Virtex6/Audio3.5Umschalter/8zu1AudioUmschalter.kicad_pcb

## KiCad design 8zu1AudioUmschalter.kicad_pcb (2015-04-05)

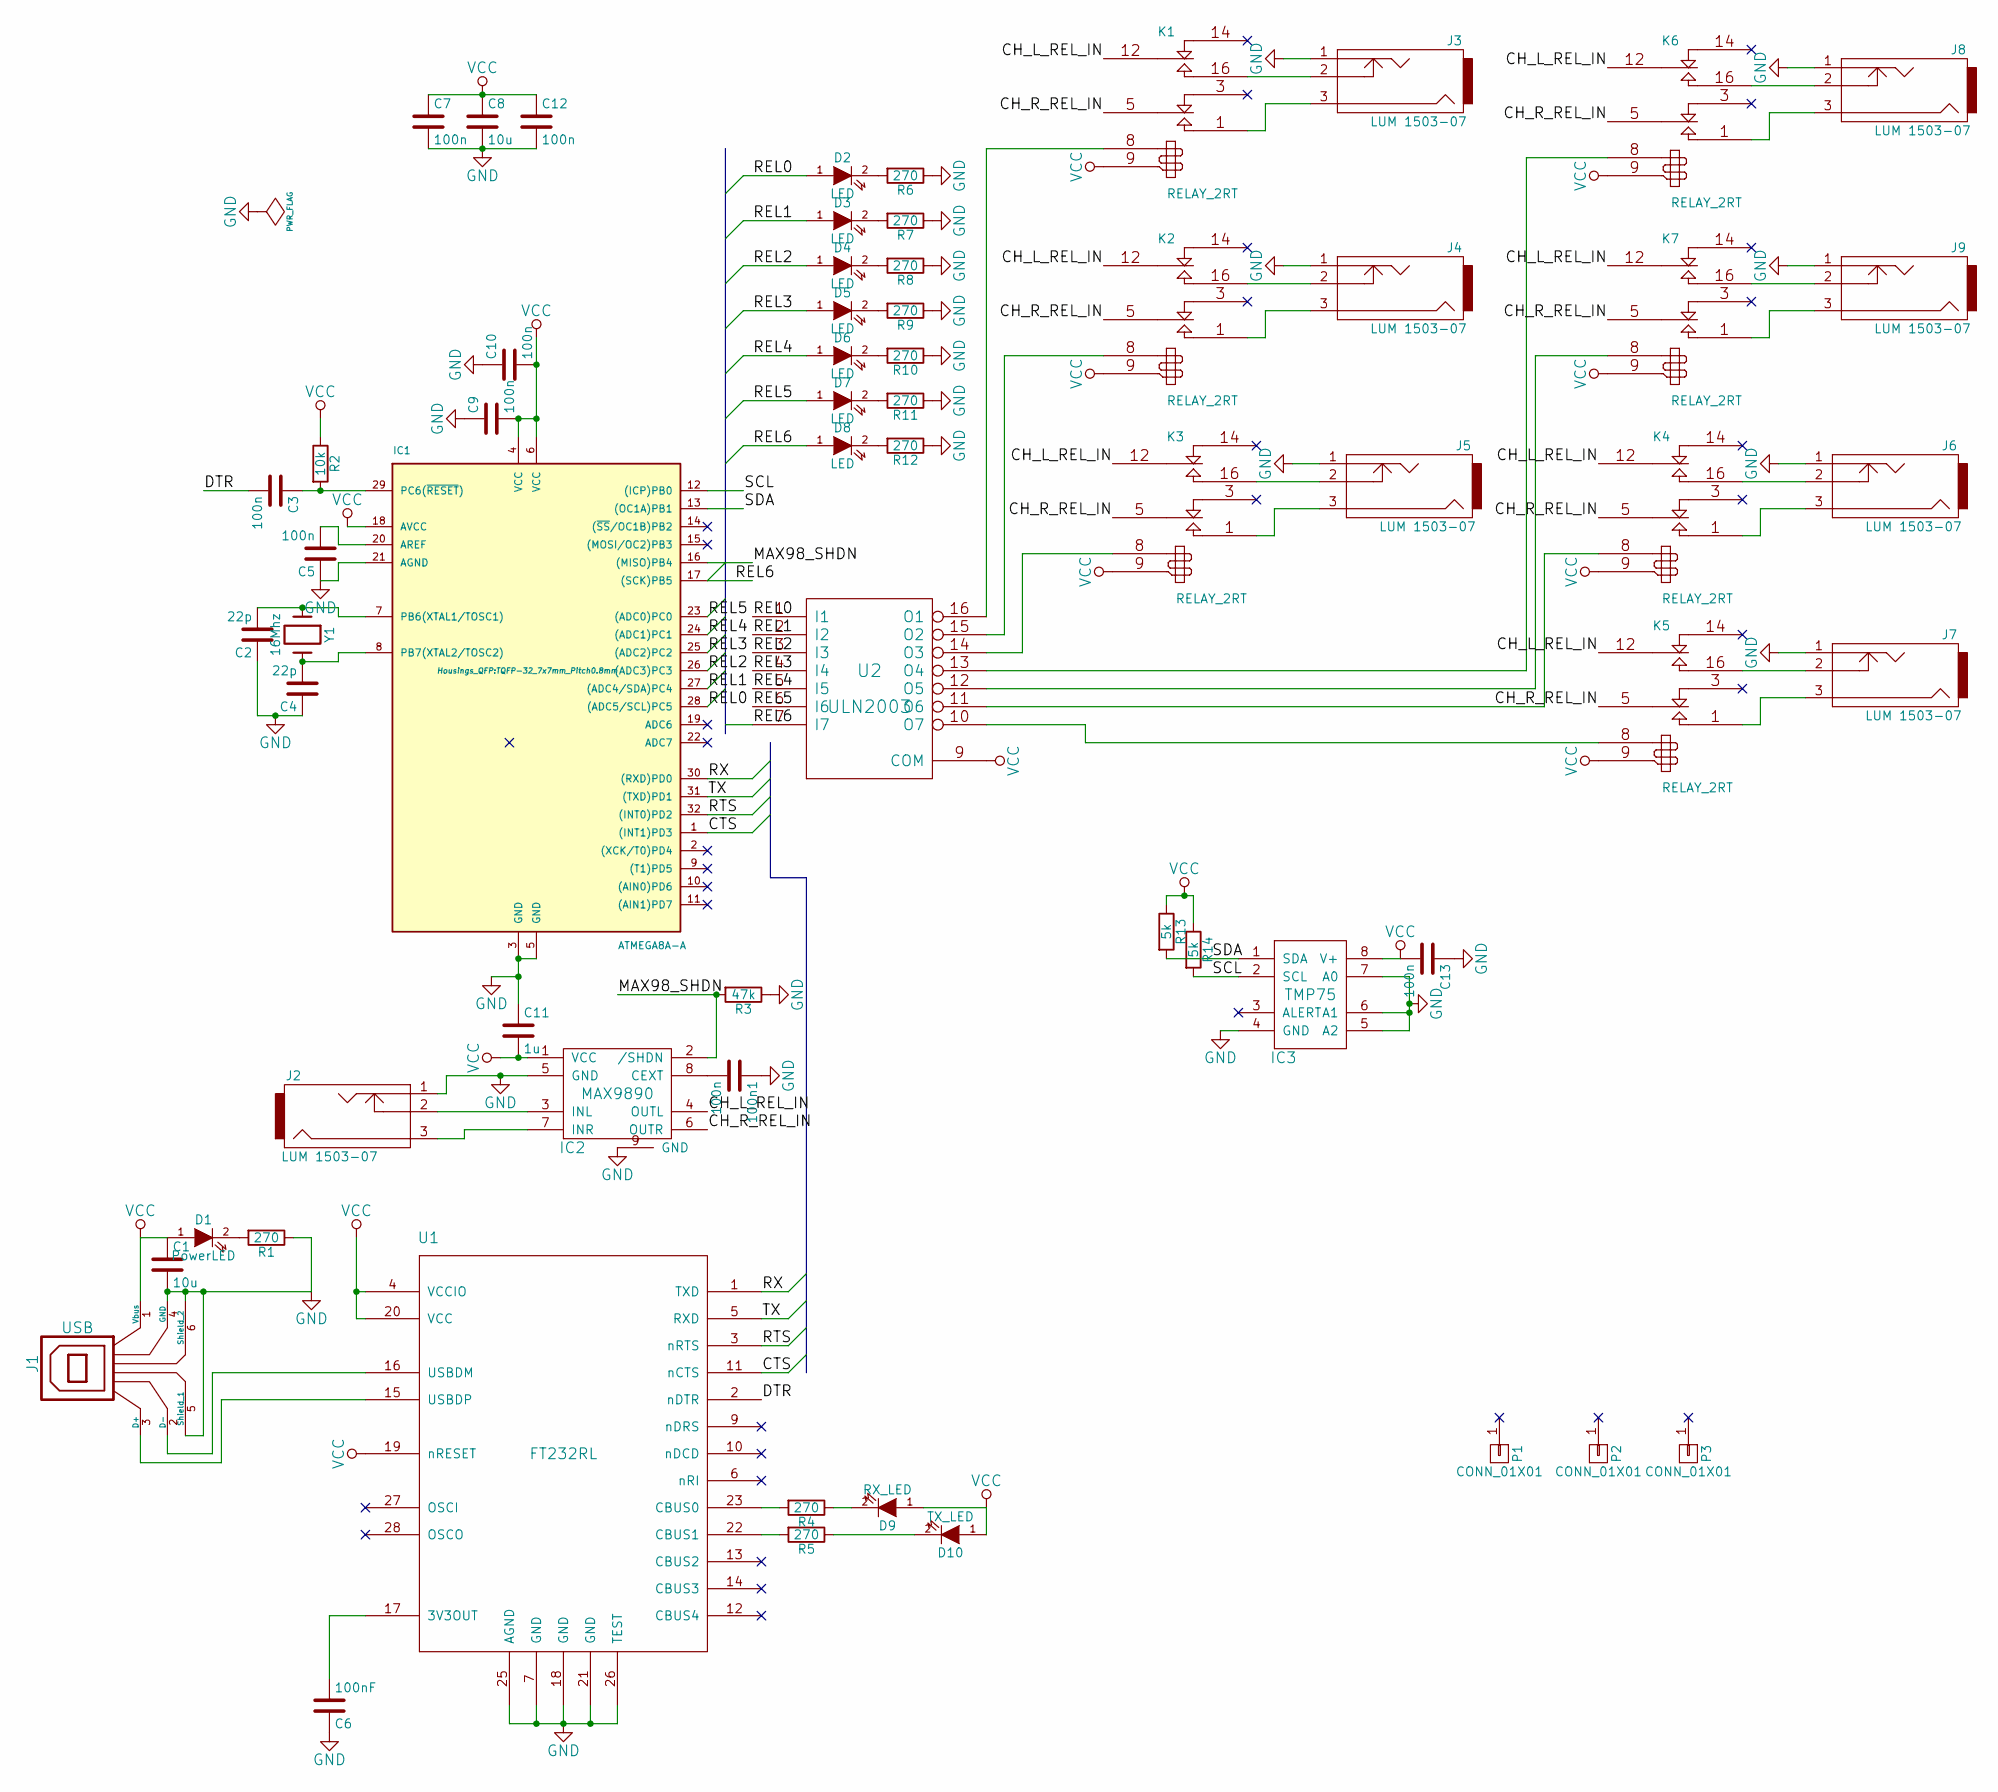
[picture p1: schematic 8zu1AudioUmschalter.sch]

Parts:
100n1: 100n; C_0603
C1, C8: 10u; C_0805
C2, C4: 22p; C_0603
C3, C5, C7, C9, C10, C12, C13: 100n; C_0603
C6: 100nF; C_0603
C11: 1u; C_0603
D1: PowerLED; LED-0603
D2, D3, D4, D5, D6, D7, D8: LED; LED-0603
D9: RX_LED; LED-0603
D10: TX_LED; LED-0603
IC1: ATMEGA8A-A; TQFP-32_7x7mm_Pitch0.8mm
IC2: MAX9890; DFN-8-1EP_3x3mm_Pitch0.65mm
IC3: TMP75; SOIC-8-N
J1: USB; USB_Mini-B
J2, J3, J4, J5, J6, J7, J8, J9: LUM 1503-07; LUM1503
K1, K2, K3, K4, K5, K6, K7: RELAY_2RT; REL_NA05W
P1, P2, P3: CONN_01X01; MountingHole_3mm
R1, R4, R5, R6, R7, R8, R9, R10, R11, R12: 270; R_0603
R2: 10k; R_0603
R3: 47k; R_0603
R13, R14: 5k; R_0603
U1: FT232RL; SSOP-28_5.3x10.2mm_Pitch0.65mm
U2: ULN2003; SO-16-N
Y1: 16Mhz; Crystal_HC49-U_Vertical

Connections:
/CH_L_REL_IN: IC2.4 (OUTL), K1.12 (C2), K2.12 (C2), K3.12 (C2), K4.12 (C2), K5.12 (C2), K6.12 (C2), K7.12 (C2)
/CH_R_REL_IN: IC2.6 (OUTR), K1.5 (C1), K2.5 (C1), K3.5 (C1), K4.5 (C1), K5.5 (C1), K6.5 (C1), K7.5 (C1)
/CTS: IC1.1 ((INT1)PD3), U1.11 (nCTS)
/DTR: C3.2, U1.2 (nDTR)
/MAX98_SHDN: IC1.16 ((MISO)PB4), IC2.2 (/SHDN), R3.2
/REL0: D2.1 (A), IC1.28 ((ADC5/SCL)PC5), U2.1 (I1)
/REL1: D3.1 (A), IC1.27 ((ADC4/SDA)PC4), U2.2 (I2)
/REL2: D4.1 (A), IC1.26 ((ADC3)PC3), U2.3 (I3)
/REL3: D5.1 (A), IC1.25 ((ADC2)PC2), U2.4 (I4)
/REL4: D6.1 (A), IC1.24 ((ADC1)PC1), U2.5 (I5)
/REL5: D7.1 (A), IC1.23 ((ADC0)PC0), U2.6 (I6)
/REL6: D8.1 (A), IC1.17 ((SCK)PB5), U2.7 (I7)
/RTS: IC1.32 ((INT0)PD2), U1.3 (nRTS)
/RX: IC1.30 ((RXD)PD0), U1.1 (TXD)
/SCL: IC1.12 ((ICP)PB0), IC3.2 (SCL), R14.2
/SDA: IC1.13 ((OC1A)PB1), IC3.1 (SDA), R13.2
/TX: IC1.31 ((TXD)PD1), U1.5 (RXD)
GND: 100n1.1, C1.2, C2.1, C4.1, C5.1, C6.1, C7.2, C8.2, C9.1, C10.1, C11.1, C12.2, C13.1, IC1.3 (GND), IC1.5 (GND), IC1.21 (AGND), IC2.5 (GND), IC2.9 (GND), IC3.4 (GND), IC3.5 (A2), IC3.6 (A1), IC3.7 (A0), J1.4 (GND), J1.5 (Shield_1), J1.6 (Shield_2), J2.1, J3.1, J4.1, J5.1, J6.1, J7.1, J8.1, J9.1, R1.1, R3.1, R6.1, R7.1, R8.1, R9.1, R10.1, R11.1, R12.1, U1.7 (GND), U1.18 (GND), U1.21 (GND), U1.25 (AGND), U1.26 (TEST), U2.8 (GND)
unnamed: 100n1.2, IC2.8 (CEXT)
unnamed: C2.2, IC1.7 (PB6(XTAL1/TOSC1)), Y1.1
unnamed: C3.1, IC1.29 (PC6(~RESET~)), R2.2
unnamed: C4.2, IC1.8 (PB7(XTAL2/TOSC2)), Y1.2
unnamed: C5.2, IC1.20 (AREF)
unnamed: C6.2, U1.17 (3V3OUT)
unnamed: D1.2 (K), R1.2
unnamed: D2.2 (K), R6.2
unnamed: D3.2 (K), R7.2
unnamed: D4.2 (K), R8.2
unnamed: D5.2 (K), R9.2
unnamed: D6.2 (K), R10.2
unnamed: D7.2 (K), R11.2
unnamed: D8.2 (K), R12.2
unnamed: D9.2 (K), R4.1
unnamed: D10.2 (K), R5.1
unnamed: IC2.3 (INL), J2.2
unnamed: IC2.7 (INR), J2.3
unnamed: J1.2 (D-), U1.16 (USBDM)
unnamed: J1.3 (D+), U1.15 (USBDP)
unnamed: J3.2, K1.16 (T2)
unnamed: J3.3, K1.1 (T1)
unnamed: J4.2, K2.16 (T2)
unnamed: J4.3, K2.1 (T1)
unnamed: J5.2, K3.16 (T2)
unnamed: J5.3, K3.1 (T1)
unnamed: J6.2, K4.16 (T2)
unnamed: J6.3, K4.1 (T1)
unnamed: J7.2, K5.16 (T2)
unnamed: J7.3, K5.1 (T1)
unnamed: J8.2, K6.16 (T2)
unnamed: J8.3, K6.1 (T1)
unnamed: J9.2, K7.16 (T2)
unnamed: J9.3, K7.1 (T1)
unnamed: K1.8, U2.16 (O1)
unnamed: K2.8, U2.15 (O2)
unnamed: K3.8, U2.14 (O3)
unnamed: K4.8, U2.11 (O6)
unnamed: K5.8, U2.10 (O7)
unnamed: K6.8, U2.13 (O4)
unnamed: K7.8, U2.12 (O5)
unnamed: R4.2, U1.23 (CBUS0)
unnamed: R5.2, U1.22 (CBUS1)
VCC: C1.1, C7.1, C8.1, C9.2, C10.2, C11.2, C12.1, C13.2, D1.1 (A), D9.1 (A), D10.1 (A), IC1.4 (VCC), IC1.6 (VCC), IC1.18 (AVCC), IC2.1 (VCC), IC3.8 (V+), J1.1 (Vbus), K1.9, K2.9, K3.9, K4.9, K5.9, K6.9, K7.9, R2.1, R13.1, R14.1, U1.4 (VCCIO), U1.19 (nRESET), U1.20 (VCC), U2.9 (COM)

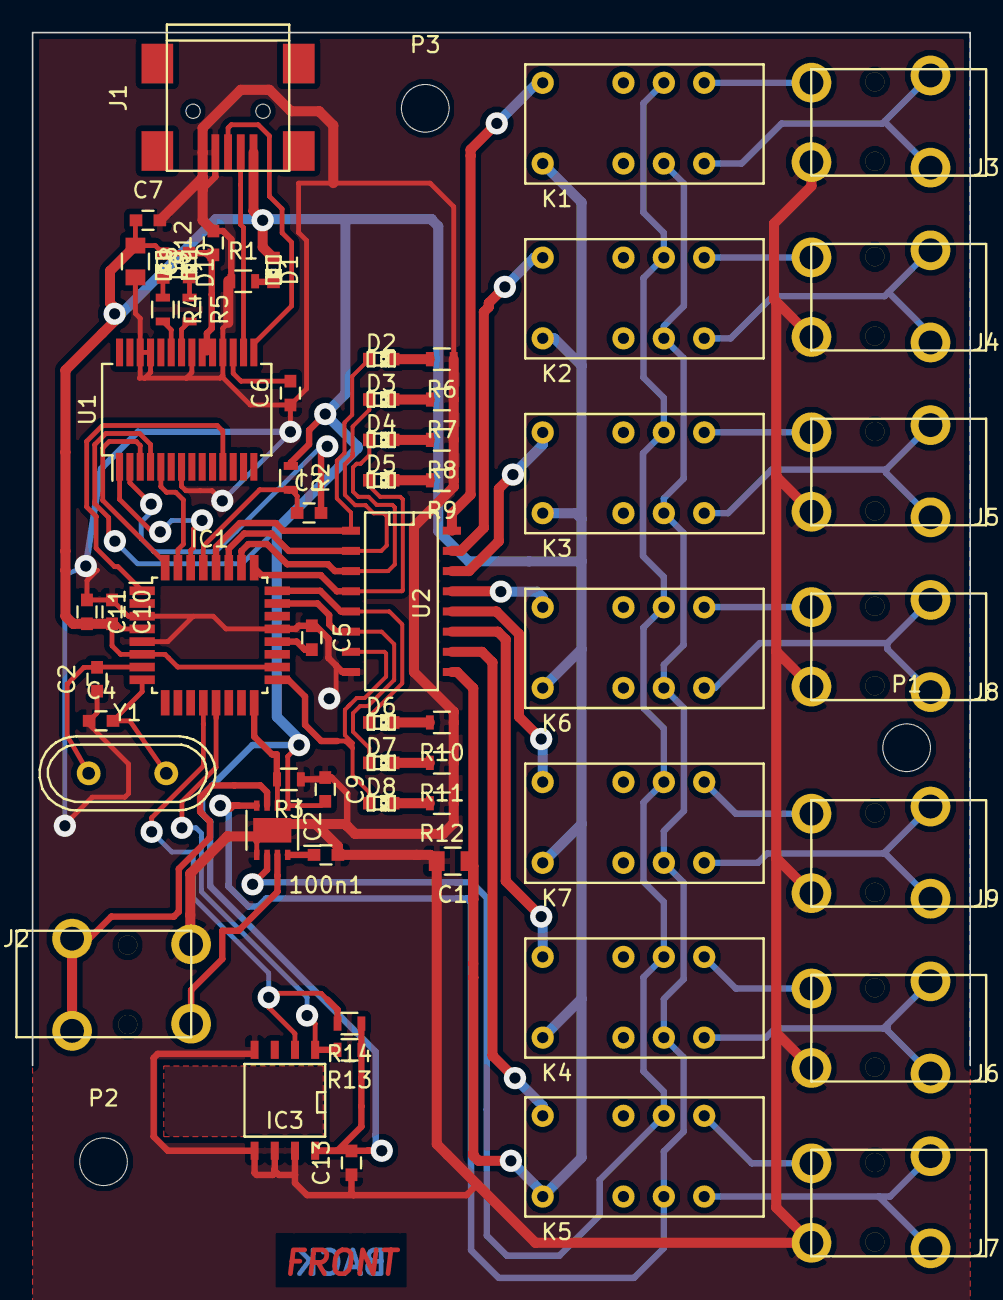
[picture p2: board 8zu1AudioUmschalter.kicad_pcb from above]

Board: 2 copper layers, 59.0 x 65.0 mm, 63 parts (0 on the bottom side), 62 nets.
