Virtex6/Audio3.5Umschalter/(commit log)

2015-03-15 Init commit
    [8zu1AudioUmschalter.sch]
2015-03-15 DTR nun als RESET für den Atmega Entfernen des Konnektors für ISP
    [8zu1AudioUmschalter.sch]
2015-03-15 Relays schalten nach low side (GND nach VCC geändert)
    [8zu1AudioUmschalter.sch]
2015-03-15 Kleinere Anpassungen am MAX9890
    [8zu1AudioUmschalter.sch]
2015-03-15 Hinzufügen von Status LEDs für die einzelnen Relais
    [8zu1AudioUmschalter.sch]
2015-03-15 Pull Down am MAX9890 um Signal bewusst zu kontrollieren
    [8zu1AudioUmschalter.sch]
2015-03-15 Hinzufügen der Libs
    [8zu1AudioUmschalter.sch]
2015-03-15 Hinzufügen eines VCC stab. Kond. am MAX9890
    [8zu1AudioUmschalter.sch]
2015-03-15 Kleinere Anpassungen
    [8zu1AudioUmschalter.sch]
2015-03-16 Hinzufügen der Footprints und Datenblätter
    [8zu1AudioUmschalter.sch]
2015-03-16 footprints für buchse und relais schauen ok aus, bauteile weiter zugeordnet
    [8zu1AudioUmschalter.sch]
2015-03-16 Aktualisierung der Footprintzuordnung, Erstellen von TDFN8
    [8zu1AudioUmschalter.sch]
2015-03-16 footprints für widerstände und maximchip angepasst
    [8zu1AudioUmschalter.sch]
2015-03-16 Erster PCB Entwurf
    [8zu1AudioUmschalter.kicad_pcb, 8zu1AudioUmschalter.sch]
2015-03-16 Erste vollständige PCB ohne Masseflächen
    [8zu1AudioUmschalter.kicad_pcb]
2015-03-16 Masseflächen dazu
    [8zu1AudioUmschalter.sch]
2015-03-17 Platine nun 59 x 80 um den Abstand zwischen den 3.5 mm Buchsen zu vergrößern
    [8zu1AudioUmschalter.kicad_pcb, 8zu1AudioUmschalter.sch]
2015-03-20 Kleinere Änderungen und Hinzufügen des TMP75
    [8zu1AudioUmschalter.kicad_pcb, 8zu1AudioUmschalter.sch]
2015-03-20 Massefläche unter TMP75 entfernt
    [8zu1AudioUmschalter.kicad_pcb]
2015-03-21 Änderungen in den Masseflächen Ist es o.k. USB shield nicht mit GND zu verbinden ?
    [8zu1AudioUmschalter.kicad_pcb]
2015-03-21 Via Bohrdurchmesser angepasst
    [8zu1AudioUmschalter.kicad_pcb]
2015-03-21 Direkte Leiterbahnen zwischen Pads entfernt
    [8zu1AudioUmschalter.kicad_pcb]
2015-04-03 Text in Kupferlage dazugefügt, damit man richtig fertigen kann.
    [8zu1AudioUmschalter.kicad_pcb]
2015-04-03 Leitungen zu den Relais auf die Back Layer gelegt
    [8zu1AudioUmschalter.kicad_pcb]
2015-04-03 Layoutfehler, TX und RX waren nicht gekreuzt.
    [8zu1AudioUmschalter.kicad_pcb, 8zu1AudioUmschalter.sch]
2015-04-05 Umpolen der Relais, da diese eine bestimmte Polarität benötigen
    [8zu1AudioUmschalter.kicad_pcb, 8zu1AudioUmschalter.sch]
